Draft4/mobile-vision-tracking-platform/vision/data/target_test_1.jpg

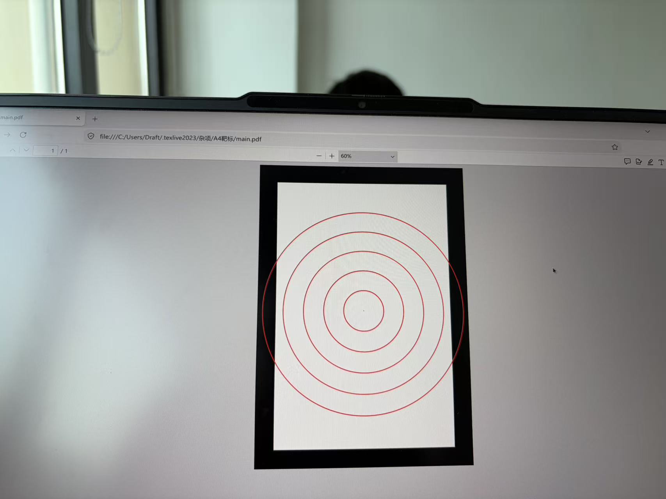
vision/data/target_test_1.jpg
