Draft4/mobile-vision-tracking-platform/mechanical/README.md

Power_Board_2026-08-07是第一版电源板，用于整车供电
Bom-Board1_PCB1是对应第一版电源板的Bom表，内部标明了所需的所有元件
