Draft4/mobile-vision-tracking-platform/gimbal/README.md

dm_ctrl(h7 fdcan)v1.1是已经和DM4310电机建立通信的代码（fdcan1通信），后续应该集成DJ6020通信代码
