Draft4/mobile-vision-tracking-platform/vision/models/README.md

# 无人机模型记录

模型文件属于大文件，不进入 Git，由网盘或项目群文件共享。当前视觉代码默认从
本目录读取 `best.pt`。

## 当前模型

| 项目 | 值 |
| --- | --- |
| 文件名 | `best.pt` |
| 模型结构 | `yolo26n.yaml` |
| 类别 | `0: drone` |
| 训练/验证图像尺寸 | 640 |
| Ultralytics 版本 | 8.4.121 |
| 文件大小 | 5,386,558 bytes |
| SHA-256 | `370A386BB966E0363EEC149E96A08F82DE9DEF872E7136CC1ED1CB723709A9C9` |
| 检查点元数据许可证 | AGPL-3.0 |
| 提供者与共享位置 | 待项目成员补充 |

部署或替换模型时，应确认类别名称仍包含 `drone`，记录新的训练版本、输入尺寸、
许可证、文件哈希和共享位置。模型输出框必须映射到相机原始图像像素坐标，才能
交给上层跟踪与角度解算。未来生成的 ONNX、TensorRT 或 RKNN 文件也遵循同样的
大文件共享规则。
