Draft4/mobile-vision-tracking-platform/mechanical/BOM_Board1_PCB1_2026-08-12.xlsx

No. | Quantity | Comment | Designator | Footprint | Value | Manufacturer Part | Manufacturer | Supplier Part | Supplier
1 | 6 | XT30PW-F | 5V,24V_1,24V_2,VBAT,VBAT1,VBAT2 | CONN-TH_XT30PW-F-1 |  | XT30PW-F | AMASS(艾迈斯) | C2913282 | LCSC
2 | 5 | WJ500V-5.08-2P | 5V,VBAT3,激光笔5v供电,电机24V_2供电（1）,电机24V_2供电（2） | CONN-TH_2P-P5.00_WJ500V-5.08-2P |  | WJ500V-5.08-2P | KANGNEX(康奈克斯电气) | C8465 | LCSC
3 | 1 | 4.7uF | C1 | C1210 | 4.7uF | GRM32ER71H475KA88L | muRata(村田) | C86052 | LCSC
4 | 1 | 100nF | C2 | C0603 | 100nF | CC0603KRX7R9BB104 | YAGEO(国巨) | C14663 | LCSC
5 | 1 | 220uF | C4 | CAP-TH_BD8.0-P3.50-D0.6-FD-2 | 220uF | KNH2220UF35V149EC0049 | KNSCHA(科尼盛) | C2981462 | LCSC
6 | 4 | 100nF | C5,C6,C9,C10 | C0603 | 100nF | FCC0603B104K500CT | FOJAN(富捷) | C5137636 | LCSC
7 | 4 | 20uF | C7,C8,C11,C12 | C2220 | 20uF | C2220X206K5RLCAUTO | KEMET(基美) | C3842434 | LCSC
8 | 1 | XT60PW-M | CN6 | CONN-TH_XT60PW-M |  | XT60PW-M | AMASS(艾迈斯) | C98732 | LCSC
9 | 1 | BZT52C16 | D11 | SOD-123_L2.7-W1.7-LS3.8-RD |  | BZT52C16 | TWGMC(台湾迪嘉) | C727007 | LCSC
10 | 1 | PZ254V-12-6P | GND4 | HDR-TH_6P-P2.54-V-M-R2-C3-S2.54 |  | PZ254V-12-6P | XFCN(兴飞) | C492420 | LCSC
11 | 4 | M3*12+3 | GND,GND1,GND2,GND3 | TH_BD4.7-D3.0 |  | M3*12+3 | XHHD(新宏辉达) | C110574 | LCSC
12 | 1 | YLED0805R | LED1 | LED_0805 |  | YLED0805R | YONGYUTAI(永裕泰) | C19171391 | LCSC
13 | 1 | HY19P03D | Q19 | TO-252-2_L6.6-W6.1-P4.57-LS9.9-TL-CW |  | HY19P03D | HUAYI(华羿微) | C122492 | LCSC
14 | 1 | 10kΩ | R3 | R0603 | 10kΩ | FRC0603J103 TS | FOJAN(富捷) | C2930027 | LCSC
15 | 1 | 4.7kΩ | R4 | R0603 | 4.7kΩ | 0603WAF4701T5E | UNI-ROYAL(厚声) | C23162 | LCSC
16 | 1 | MT-0-102-C003-N003-RS | SW1 | SW-TH_MT-0-102-C003-N003-RS |  | MT-0-102-C003-N003-RS | YUEN FUNG(源丰) | C1788495 | LCSC
17 | 4 | MST22D18G2 | SW5V_1,SW5V_2,SW24V_1,SW24V_2 | SW-SMD_MST22D18G2 |  | MST22D18G2 | SHOU HAN(首韩) | C431544 | LCSC
18 | 2 | TYPE-C 6P | USB1_VBAT,USB2_VBAT | TYPE-C-SMD_TYPE-C-6P_1 |  | TYPE-C 6P | SHOU HAN(首韩) | C456012 | LCSC
19 | 2 | XL6009 | VBAT升压24V_1,VBAT升压24V_2 | XL6009
20 | 2 | TPS5450降压模块 | VBAT降压5V_1,VBAT降压5V_2 | TPS5450降压模块
21 | 2 | HDGC1501WR-S-6P | 电机485输入1,电机485输入2 | CONN-SMD_6P-P1.50_HDGC1501WR-S-6P |  | HDGC1501WR-S-6P | HDGC(华德共创) | C2936220 | LCSC
22 | 1 | XH-2AW | 电机信号线 | CONN-TH_XH-2AW_C2908611 |  | XH-2AW | HCTL(华灿天禄) | C2908611 | LCSC
