Draft4/mobile-vision-tracking-platform/(list of files, drawings)

Other design files:
mechanical/Power_Board_2026-08-07.eprj
