Draft4/mobile-vision-tracking-platform/gimbal/dm_ctrl(h7 fdcan) v1.1/Core/Src/main.c

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
/* Includes ------------------------------------------------------------------*/
#include "main.h"
#include "fdcan.h"
#include "tim.h"
#include "usart.h"
#include "gpio.h"

/* USER CODE BEGIN Includes */
#include "bsp_fdcan.h"
#include "dm_motor_ctrl.h"
/* USER CODE END Includes */


void SystemClock_Config(void);
/* USER CODE BEGIN 0 */
void HAL_TIM_PeriodElapsedCallback(TIM_HandleTypeDef *htim)
{
  /* USER CODE BEGIN Callback 0 */
	if (htim->Instance == TIM3) {
		
		read_all_motor_data(&motor[Motor1]);
		
		if(motor[Motor1].tmp.read_flag == 0)
			dm_motor_ctrl_send(&hfdcan1, &motor[Motor1]);
	}
}
/* USER CODE END 0 */                                 

/**
  * @brief  The application entry point.
  * @retval int
  */
int main(void)
{

  /* MCU Configuration--------------------------------------------------------*/

  /* Reset of all peripherals, Initializes the Flash interface and the Systick. */
  HAL_Init();

  /* Configure the system clock */
  SystemClock_Config();

  /* Initialize all configured peripherals */
  MX_GPIO_Init();
  MX_FDCAN1_Init();
  MX_TIM3_Init();
  MX_USART1_UART_Init();  
  MX_TIM4_Init();
  /* USER CODE BEGIN 2 */
	power(1);
	HAL_Delay(1000);
	
	bsp_fdcan_set_baud(&hfdcan1, CAN_CLASS, CAN_BR_1M);

	bsp_can_init();
	dm_motor_init();

	motor[Motor1].ctrl.mode    = mit_mode;
	HAL_Delay(100);
	
	write_motor_data(motor[Motor1].id, 10, mit_mode, 0, 0, 0);
	HAL_Delay(100);
//	write_motor_data(motor[Motor1].id, 35, CAN_BR_5M, 0, 0, 0);
//	HAL_Delay(100);
	read_motor_data(motor[Motor1].id, RID_CAN_BR); 
	dm_motor_disable(&hfdcan1, &motor[Motor1]);
	HAL_Delay(100);
	save_motor_data(motor[Motor1].id, 10);
	HAL_Delay(100);
	
//电机参数设计
	motor[Motor1].ctrl.pos_set = motor[Motor1].para.pos;
	motor[Motor1].ctrl.vel_set = 5.0f;
	motor[Motor1].ctrl.kp_set  = 0.0f;
	motor[Motor1].ctrl.kd_set  = 1.0f;
	motor[Motor1].ctrl.tor_set = 0.0f;
	dm_motor_enable(&hfdcan1, &motor[Motor1]);	
	
	HAL_Delay(1000);
	
	HAL_TIM_Base_Start_IT(&htim3);
//	read_all_motor_data(&motor[Motor1]);
  /* USER CODE END 2 */

  /* Infinite loop */
  /* USER CODE BEGIN WHILE */
  while (1)
  {
    /* USER CODE END WHILE */

    /* USER CODE BEGIN 3 */
  }
  /* USER CODE END 3 */
}

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
