Draft4/mobile-vision-tracking-platform/(commit log)

2026-08-13 docs: 初始化项目目录与协作说明
2026-08-13 docs: 添加坐标系与方向约定
2026-08-13 docs: 清理坐标系文档格式
2026-08-13 docs: 调整坐标系说明
2026-08-14 vision: 增加相机采集与外框靶标检测基线
2026-08-15 vision: 增加 V2 内区矩形靶标检测
2026-08-17 vision: 增加无人机录像并完善实时检测
2026-08-20 Update repository contents
    [BOM_Board1_PCB1_2026-08-12.xlsx, Power_Board_2026-08-07.eprj]
2026-08-20 Add initial README with power board details
2026-08-20 Add README for dm_ctrl(h7 fdcan) v1.1
    Added initial communication code for DM4310 motor.
2026-08-21 vision:增加相机标定与无人机跟踪能力
2026-08-24 vision:增加激光标定与云台测量协议
2026-08-25 Add files via upload
    该程序通过STM32接收RK3588的视觉角度误差，并控制DM4310俯仰轴和PWM模式GM6020方位轴，实现云台实时跟踪与丢失目标自动搜索。
