Draft4/mobile-vision-tracking-platform/(notices)

Notices in the files:
gimbal/dm_ctrl(h7 fdcan) v1.1/Core/Src/main.c:
Copyright (c) 2024 STMicroelectronics.
All rights reserved.
This software is licensed under terms that can be found in the LICENSE file
